SYR8/PhytoAI/test-data/PhytoAI-demo-data.xlsx

Sheet: Events
EventID | Timestamp | EventType | MoisturePercent | SoilTempC | WaterTempC | AirTempC | AirHumidityPercent | WeightGrams | LightLevel | TankEmpty | WateringTriggered | WaterDurationSeconds | HeaterUsed | HeaterDurationSeconds | SpeciesGuess | SpeciesConfidence | PhotoFileID | AnomalyDetected | AnomalyDescription | AI_Notes | ReasoningSummary | WateringAborted | FinalWaterTempC | WaterAddedGrams
wroom-1789822803 | 2026-09-19T13:00:18Z | sunset | 1 | 22.06 | 21.81 | 23.5 | 47.1 | 136.9 | 1 | FALSE | TRUE | 30 | FALSE | 0 | Monstera deliciosa | 0.7 |  | TRUE |  | The system is in a state of extreme moisture deficit (1%) with no historical baseline. While the moisture level is critically low, the lack of historical trends makes it impossible to determine the rate of drying. However, for a Monstera deliciosa, 1% moisture is an emergency state. | The current moisture reading is 1%, which is critically low for a Monstera deliciosa. Although there is no historical trend data (moisture_trend: unknown) and no previous watering events recorded, the absolute value of 1% moisture indicates an immediate need for hydration to prevent plant death. Water temperature (21.81C) is slightly cooler than soil (22.06C), so no heater is required. | FALSE
cam-20260919 | 2026-09-19T15:19:40Z | photo |  |  |  |  |  |  |  |  |  |  |  |  | Aloe vera | 0.3 |  | FALSE |  | The image is quite blurry and poorly lit, making a definitive identification difficult. However, the leaf structure (succulent, pointed, arranged in a rosette) is inconsistent with the previous 'Monstera deliciosa' record. It looks more like an Aloe or a similar succulent. No obvious disease or pests are visible despite the low image quality.

Sheet: SystemConfig
Key | Value | LastUpdated
pot_latitude | 49.9886
pot_longitude | 8.5958
last_watered_utc | 2026-09-19T13:00:21Z | 2026-09-19T13:00:21Z
last_species_guess | Monstera deliciosa
species_confidence | 0.7
current_temp_tolerance_c | 25 | 2026-09-19T13:00:21Z
next_sunrise_utc | 2026-09-19T05:06:25Z
next_sunset_utc | 2026-09-19T17:32:07Z
last_tank_empty_alert_sent | 2026-09-19T11:53:04Z
dry_run_mode | TRUE | 2026-09-19T12:00:00Z
min_rewater_interval_hours | 6
scan_session_active | FALSE | 2026-09-19T15:08:28Z
scan_auto | TRUE | 2026-09-19T12:00:00Z
scan_next_utc
camera_battery_percent | 78 | 2026-09-19T15:19:44Z
camera_battery_min_percent | 30
drive_daily_photos_folder_id
drive_scan_photos_folder_id
push_vapid_public_key
max_pump_seconds | 60
preheat_margin_c | 2
preheat_lead_minutes | 25
max_water_temp_c | 28
heater_hysteresis_c | 2
last_lightlevel | 1 | 2026-09-19T13:00:21Z
last_lightlevel_utc | 2026-09-19T13:00:21Z | 2026-09-19T13:00:21Z
flash_dark_threshold | 1
perenual_species_id
perenual_status
perenual_cached_species
perenual_cached_utc
perenual_common_name
perenual_water_benchmark
perenual_care_json

Sheet: Notifications
timestamp | type | title | message | response_options | status | response | resume_url | context_ref
2026-09-19T12:24:38Z | watering_feedback | Watering decision - was this right? | Event sunset: needs_watering=true, duration 15s. Reasoning: The plant is a Monstera deliciosa with 0% moisture and no recorded watering history. While 0% moisture is often an error in new setups, without a trend to compare against, the current state indicates a critical need for hydration. Water temperature (21.87C) is slightly cooler than soil (21.94C), so no heater is required. | ["👍","👎"] | done |  |  | wroom-1789820665
2026-09-19T13:00:19Z | watering_feedback | Watering decision - was this right? | Event sunset: needs_watering=true, duration 30s. Reasoning: The current moisture reading is 1%, which is critically low for a Monstera deliciosa. Although there is no historical trend data (moisture_trend: unknown) and no previous watering events recorded, the absolute value of 1% moisture indicates an immediate need for hydration to prevent plant death. Water temperature (21.81C) is slightly cooler than soil (22.06C), so no heater is required. | ["👍","👎"] | done |  |  | wroom-1789822803

Sheet: DiseaseScans
timestamp | drive_links | vision_opinion | yolo_opinion | judge_verdict | judge_reasoning | treatment_plan | user_verdict | treatment_outcome | ai_notes
2026-09-19T14:38:37Z |  | {"framing_quality":"poor (no plant present)","symptoms_observed":["none"],"suspected_issues":["not applicable"],"confidence":1,"affected_areas":["none"]} | {"status":"ok","label":"Potato___Late_blight","label_simple":"late blight","confidence":0.3832,"top3":[{"label":"Potato___Late_blight","confidence":0.3832},{"label":"Pepper,_bell___Bacterial_spot","confidence":0.182},{"label":"Corn_(maize)___healthy","confidence":0.0826}],"model":"plantvillage-yolov8n-cls"} | monitor | The Vision Analyst reports poor framing with no plant visible, which is the most reliable indicator that no symptoms can be assessed. The YOLO output is highly unreliable due to low confidence (0.38) and a significant species mismatch (predicting Potato/Pepper/Corn for a Monstera deliciosa). Following the weighting instructions, YOLO is treated as low weight and its prediction of 'late blight' is disregarded as a false positive caused by poor image quality/framing. Since no plant is visible, no health status can be confirmed.

Sheet: AgentNotes
timestamp | agent | note | context_ref | status
2026-09-19T12:24:41Z | Decision Agent | Initial setup state detected. No historical baseline for moisture or weight trends exists. | wroom-1789820665 | active
2026-09-19T12:24:42Z | History Analyst | Insufficient data for trend analysis. | wroom-1789820665 | active
2026-09-19T12:24:42Z | History Analyst | No watering events recorded in the last 7 or 30 days. | wroom-1789820665 | active
2026-09-19T12:24:42Z | History Analyst | Species identified as Monstera deliciosa with 0.7 confidence. | wroom-1789820665 | active
2026-09-19T14:38:58Z | Judge | Vision Analyst reports no plant present in frame. | 2026-09-19T14:38:37Z | active
2026-09-19T14:38:58Z | Judge | YOLO confidence is extremely low (0.38) and misaligned with species. | 2026-09-19T14:38:37Z | active

Sheet: PushSubscriptions
timestamp | endpoint | p256dh | auth | expiration_time | user_agent | status
