SYR8/PhytoAI/test-data/dashboard-seed/DiseaseScans.csv

timestamp | drive_links | vision_opinion | yolo_opinion | judge_verdict | judge_reasoning | treatment_plan | user_verdict | treatment_outcome | ai_notes
2026-09-05T06:20:00Z |  | {"framing_quality":"good","symptoms_observed":["SAMPLE DATA - faint mottling on two leaves (test pack, not a real plant)"],"suspected_issues":[],"confidence":0.4} | {"status":"ok","label":"Monstera___healthy","confidence":0.71} | healthy | SAMPLE DATA - no actionable symptoms; low-weight model agreement (test pack, not a real plant) | SAMPLE DATA - no treatment indicated in sample data (test pack, not a real plant) |  |  | SAMPLE DATA - vision summary for the sample scan (test pack, not a real plant)
2026-09-12T06:25:00Z |  | {"framing_quality":"fair","symptoms_observed":["SAMPLE DATA - dark spot on one leaf edge (test pack, not a real plant)"],"suspected_issues":["SAMPLE DATA - possible fungal spot (test pack, not a real plant)"],"confidence":0.55} | {"status":"ok","label":"Monstera___leaf_spot","confidence":0.48} | monitor | SAMPLE DATA - spot is small and confidence is low; watch for spread (test pack, not a real plant) | SAMPLE DATA - isolate affected leaf area, monitor humidity in sample data (test pack, not a real plant) |  |  | SAMPLE DATA - sample scan notes (test pack, not a real plant)
2026-09-14T06:20:00Z |  | {"framing_quality":"good","symptoms_observed":[],"suspected_issues":[],"confidence":0.6} | {"status":"ok","label":"Monstera___healthy","confidence":0.8} | healthy | SAMPLE DATA - no symptoms observed in the sample scan (test pack, not a real plant) |  |  |  | SAMPLE DATA - sample scan notes (test pack, not a real plant)
