SYR8/PhytoAI/test-data/dashboard-seed/Events.csv

EventID | Timestamp | EventType | MoisturePercent | SoilTempC | WaterTempC | AirTempC | AirHumidityPercent | WeightGrams | LightLevel | TankEmpty | WateringTriggered | WaterDurationSeconds | HeaterUsed | HeaterDurationSeconds | SpeciesGuess | SpeciesConfidence | PhotoFileID | AnomalyDetected | AnomalyDescription | AI_Notes | ReasoningSummary | WateringAborted | FinalWaterTempC | WaterAddedGrams
test-pack1788243000 | 2026-09-01T06:10:00Z | sunrise | 47.4 | 21.6 | 21.7 | 24.6 | 47 | 2136.5 | 1 | FALSE | FALSE | 0 | FALSE | 0 | Monstera deliciosa | 0.86 |  | FALSE |  |  | SAMPLE DATA - conditions within the recent range; no watering needed (test pack, not a real plant)
test-pack1788265800 | 2026-09-01T12:30:00Z | sensor | 46.7 | 21.8 | 21.8 | 24.7 | 47 | 2133 | 1 | FALSE | FALSE | 0 | FALSE | 0 | Monstera deliciosa | 0.86 |  | FALSE |  |  | SAMPLE DATA - conditions within the recent range; no watering needed (test pack, not a real plant)
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
