SYR8/PhytoAI/(commit log)

2026-09-10 Phase 3: camera autonomy removal, Branch C panel, Notifications HITL, AgentNotes, shared Gemma rewire
    - Change 1: removed all mapping/BranchMap/pan-tilt nodes, 4 map/scan-position webhooks, Weekly Cycle Flip, Create MapPhotos Folder (43 nodes deleted across chunks)
    - Change 2/4: Telegram removed (all 6 nodes); Notifications HITL rows with Wait resume+timeout (60min position / 7d verdict+followup); Branch C Vision Analyst + YOLO stub + Judge + Treatment Advisor panel; DiseaseScans new schema; battery monitoring
    - Change 5: AgentNotes working memory (5 agents read own active notes + append 1-3 per run), disabled Plant Profile Agent placeholder
    - Rewire: all agents on shared OpenRouter Gemma (g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
2026-09-10 Phase 4: configurable camera battery threshold; minimal dashboard (Sheets reader + HITL resume buttons); Plan/README updates
2026-09-10 Sync live export: restore Gemma OpenRouter baseURL (Plan 5); wire 46 Sheets nodes to Google Sheets Zaki credential
2026-09-10 Sync live export: shared Gemma subnode now native lmChatOpenRouter (model google/gemma-4-26b-a4b-it, temperature 0.2, OpenRouter account cred)
2026-09-10 Firmware changes 7-9: relay rewrite, safety decisions, /core/sensor/result contract, schema + Phase-5 lists
2026-09-10 Hardware list: pump rated 3V-5V per listing; remove servo line
2026-09-11 Firmware changes 7-9: resolve H3 (26C thermostat, clamp target <=25C), H5 (waterproof probes), H6 (500ml preheat math), H8 partial (expansion-board wiring)
2026-09-11 Phase-5 docs: integrate Changes 10-11 (scheduled camera, placement review) into change list and sync checklist
2026-09-12 firmware: add Deliverable 1 ESP32 WROOM calibration/test sketch
2026-09-12 firmware: use ADC_11db directly (fix compile on ESP32 core where ADC_ATTEN_DB_12 is undeclared)
    [wroom_calibration.ino]
2026-09-12 firmware: fix 'r' weight read to use tare-aware scale.get_units (no double scale division)
    [wroom_calibration.ino]
2026-09-12 fix: XKC empty level is LOW (verified on hardware)
    [wroom_calibration.ino]
2026-09-13 firmware: bake verified calibration (XKC empty=LOW, soil ADC 4095/2038, DS18B20 addresses); keep HX711/flow provisional; add heater TODO + tank-empty interlock placeholders
2026-09-13 feat: ESP32-CAM bench-test firmware (staged serial menu)
2026-09-13 docs: correct ESP32-CAM spec done path to /yolo-scan/done (matches live workflow)
2026-09-13 fix: camera config SCCB pin field names for bundled esp32-camera
    [esp32cam.ino]
2026-09-13 fix: Branch B tolerates empty Events history / missing sensor row
2026-09-13 fix: camera warm-up frames for AWB convergence
    [esp32cam.ino]
2026-09-13 feat: flash LED off-by-default + 'f' torch toggle command
2026-09-13 fix: match Set node field casing to sheet headers (case-sensitive Sheets matching)
2026-09-13 fix: switch Sheets nodes to From-list sheet selection + Key matching + value expressions
2026-09-14 fix(cam): WB sunny + AE -2 + UXGA for flash-lit plant photos
    [esp32cam.ino]
2026-09-14 fix(cam): flash gated by measured room light via config webhook + capture-path flash bugfix
    [esp32cam.ino]
2026-09-14 fix(cam): arm flash before warmup so AE/WB converge under flash light
    [esp32cam.ino]
2026-09-14 feat: two-stage YOLO training pipeline (bootstrap + flywheel replay)
2026-09-14 docs: sync Plan section 2 to audited v2 sheet (Events columns, SystemConfig keys, boolean rule)
    [PhytoAI.v2.xlsx]
2026-09-14 feat(firmware): ESP32-CAM production autonomous sketch + 14-test plan (compile-verified, not flashed)
2026-09-14 feat(workflow): autonomous weekly scan (Change 10) - no camera-approval gate, session watchdog; STATUS/Plan sync + simulation evidence (exec 691-696)
2026-09-15 fix(firmware): WROOM HX711 offset-compensated calibration (stale factor dropped) + bench-only heater test on CH2/GPIO16
    [wroom_calibration.ino]
2026-09-15 docs: bench run 2026-09-15 — calibration constants recorded (HX711 factor, relay polarity, tank level, soil limits, DS18B20 addrs, pump flow)
2026-09-15 docs: WROOM production brief (WiFi/HTTP respec) + pin-map errata, audit M9, STATUS Q17-Q22
2026-09-15 fix(firmware): WROOM operating rules - no auto-tare (NVS offset restore), explicit install tare, measured wt_delta vs ml_est, heater target stop, wired-only camera
    [wroom_production.ino]
2026-09-16 chore(dashboard): test-data seed pack + spreadsheet override
    [AgentNotes.csv, DiseaseScans.csv, Events.csv, Notifications.csv, SystemConfig.csv]
2026-09-16 chore: remove or isolate approved obsolete files
    [PhytoAI.v2.xlsx]
2026-09-16 docs: remove private BWKI submission material from public repository
2026-09-19 feat(wroom): add debug send 's', runtime actuator cap 'l', optional boot POST
2026-09-19 docs(submission): add reviewer setup guide and clean demo dataset
    [PhytoAI-demo-data.xlsx]
